Kaikaikaifang/Electronic-System-Design-Practice/原理图仿真/ppxA6AqUHD.jpg

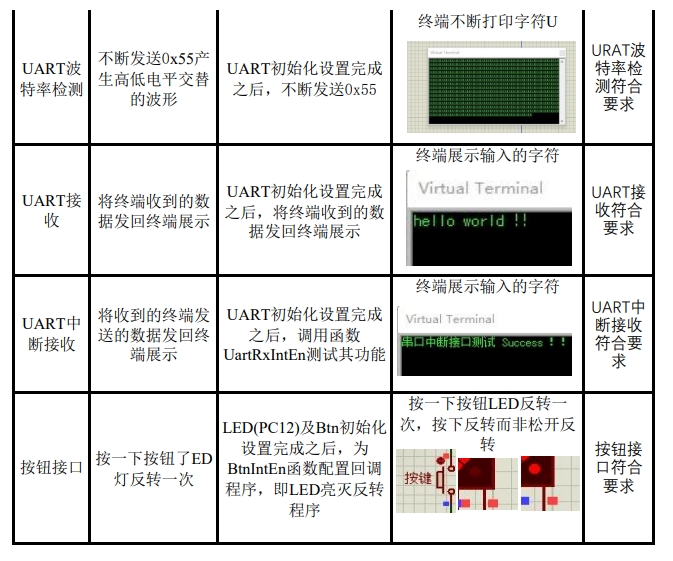
原理图仿真/ppxA6AqUHD.jpg
