Kaikaikaifang/Electronic-System-Design-Practice/线下实验/1.jpg

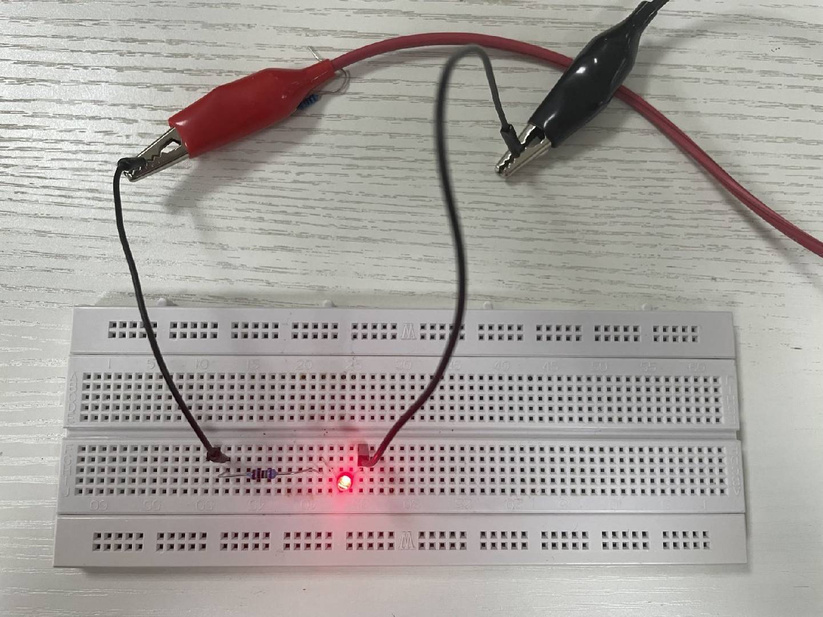
线下实验/1.jpg
