Kaikaikaifang/Electronic-System-Design-Practice/原理图仿真/原理图仿真 季开放 21009101425.pdf

模块 | 功能描述 | 程序设计思路 | 现象及描述 | 结果
LED驱动 模块 | 指示灯延时一段 时间亮灭切换一 次 | PC12初始化设置完成 后，周期改变PC12输 出，使指示灯亮灭交替 进行 | 数码管指示灯亮灭交替 | LED驱动 电路符 合要求
数码显示 | 定时循环显示0-9 | 初始化数码管驱动电路 后，周期改变数码管显 示数值 | 数码管显示数值0-9周期变 化 | 数码显 示符合 要求
定时器4 | 利用定时器4控制 LED的亮灭切换 | Tim4及PC12初始化设置 完成之后，用Tim4设置 0.5s定时来控制工作指 示灯亮灭切换 | 工作指示灯每隔0.5s切换 一次 | 定时器4 符合要 求
UART发 送 | 延时循环发送0-9 至终端 | UART初始化设置完成 之后，延时循环发送0-9 至终端 | 控制台循环打印字符0-9 | URAT发 送符合 要求
PWM控制 | 延时改变速度 | Motor初始化设置完成之 后，周期改变速度 | 示波器波形变化 | PWM控 制符合 要求
ADC测量 | 采集数据并通过 接口发送到终端 | 初始化设置Uart及 TempMeas后，周期测量 数据并通过串口发送到 终端 | 调节电阻发现，随电阻阻 值升高，采集到的数据变 大 | ADC测量 符合要 求
TIM2 | 利用定时器2控制 LED切换

Tim2及PC12初始化设置
完成后，用Tim2设置
0.2s定时来控制工作指
示灯亮灭切换

工作指示灯每隔0.2s切换
一次亮灭
TIM2符
合要求

原理图仿真记录表

UART波
特率检测

不断发送0x55产
生高低电平交替
的波形

UART初始化设置完成
之后，不断发送0x55

终端不断打印字符U
URAT波
特率检
测符合
要求

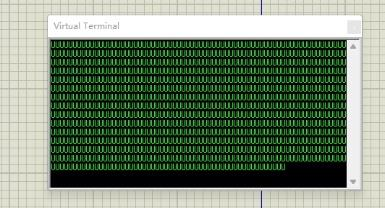
[picture p13: figure]

UART接 收 | 将终端收到的数 据发回终端展示 | UART初始化设置完成 之后，将终端收到的数 据发回终端展示 | 终端展示输入的字符 | UART接 收符合 要求
UART中 断接收 | 将收到的终端发 送的数据发回终 端展示 | UART初始化设置完成 之后，调用函数 UartRxIntEn测试其功能 | 终端展示输入的字符 | UART中 断接收 符合要 求
按钮接口 | 按一下按钮了ED 灯反转一次 | LED(PC12)及Btn初始化 设置完成之后，为 BtnIntEn函数配置回调 程序，即LED亮灭反转 程序 | 按一下按钮LED反转一 次，按下反转而非松开反 转 | 按钮接 口符合 要求
