Kaikaikaifang/Electronic-System-Design-Practice/PCB/PCB 检查汇总 季开放 21009101425.pdf

## PCB检查汇总

设计者姓名和学号 | 季开放 21009101425
错误类型 | 详细描述
元件错误或丢失 | 无

注：每类错误，若行数不够，可自行加行。

元件位号错误或
丢失

无

连接错误或丢失

无

导线太窄

无

导线太近

无

所有地是否连接
在一起

否

姓名和学号是否 标注 | 是
其它错误 | 无
