Kaikaikaifang/Electronic-System-Design-Practice/PCB/7NOwkH1fQ8.jpg

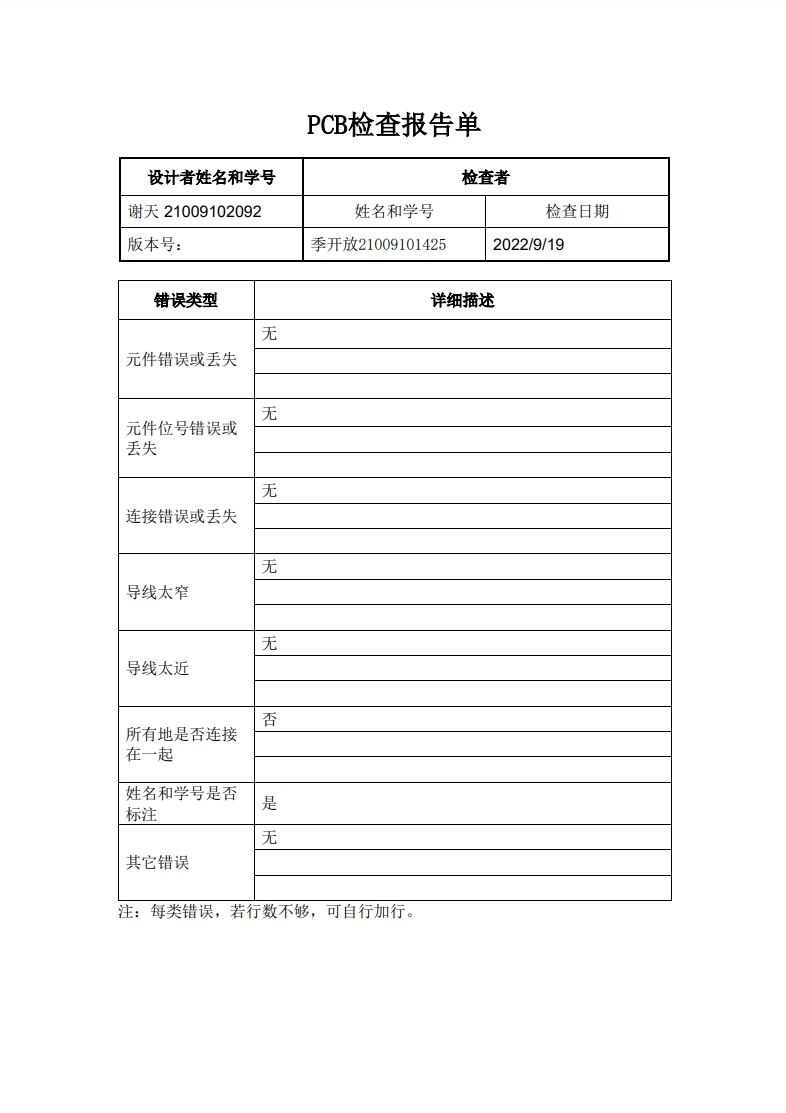
PCB/7NOwkH1fQ8.jpg
