Kaikaikaifang/Electronic-System-Design-Practice/PCB/ivbXwXM4Zm.jpg

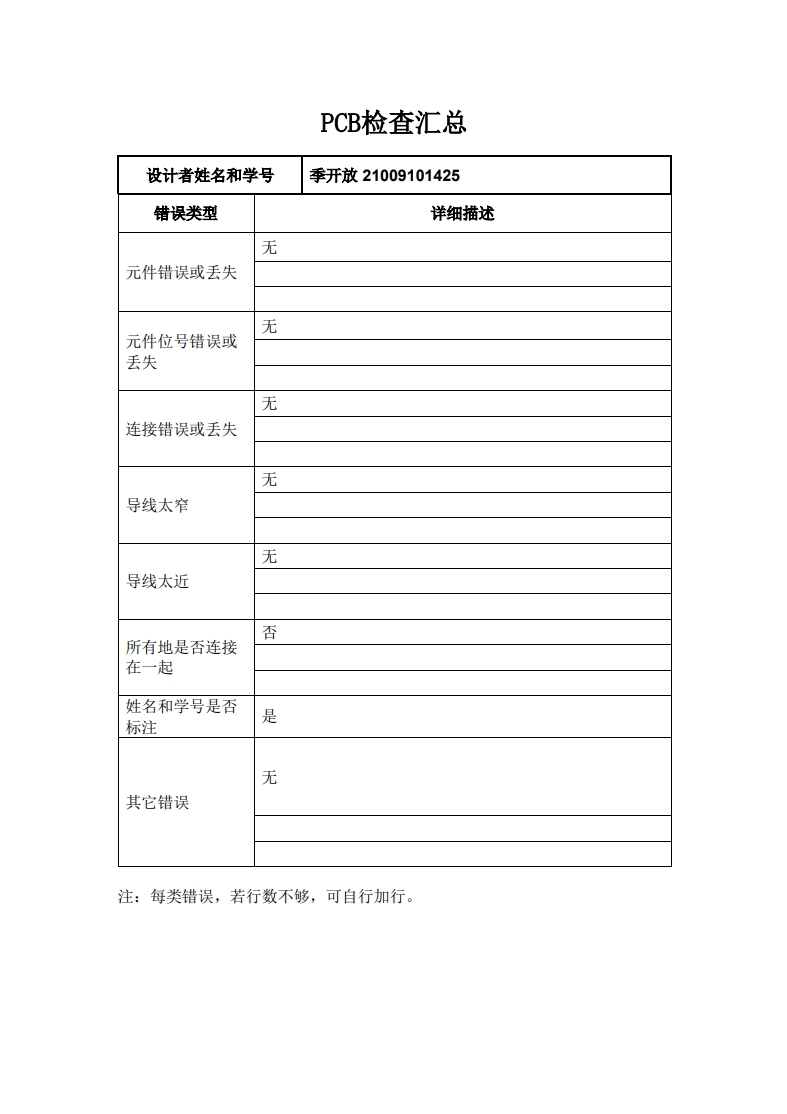
PCB/ivbXwXM4Zm.jpg
