Kaikaikaifang/Electronic-System-Design-Practice/PCB/SDzEGWgmNF.jpg

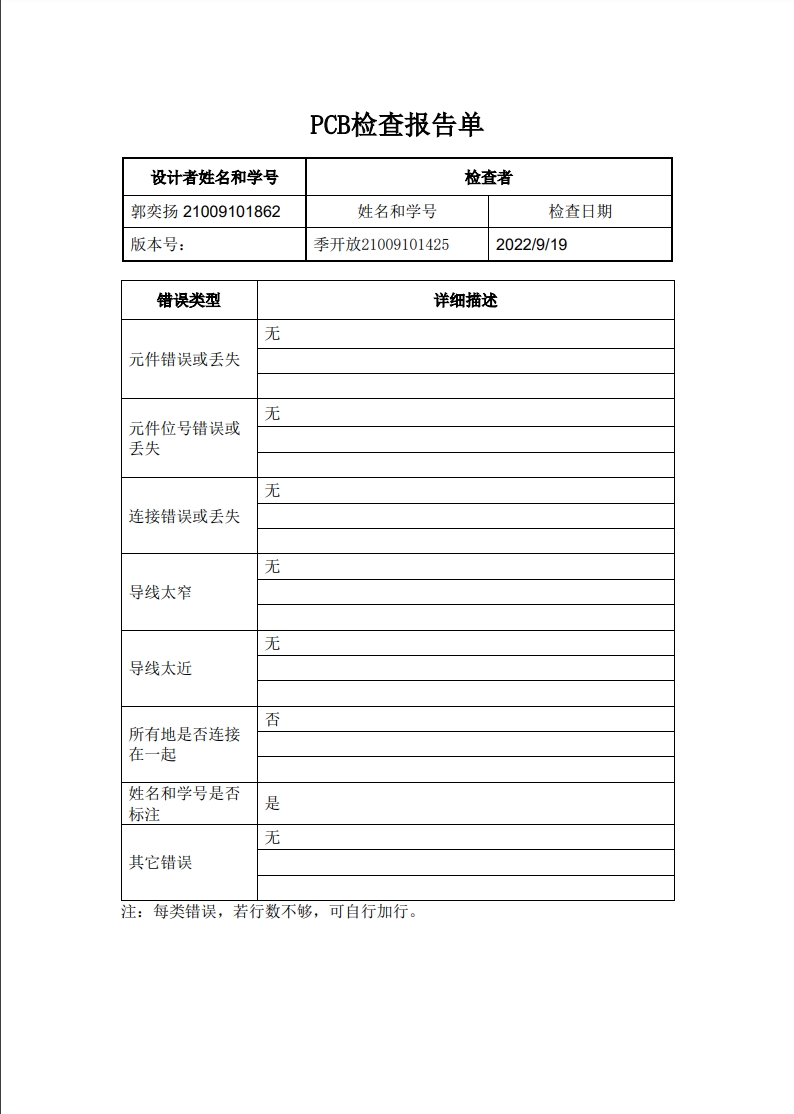
PCB/SDzEGWgmNF.jpg
