Kaikaikaifang/Electronic-System-Design-Practice/原理图仿真/5Mq5GWQv8Y.jpg

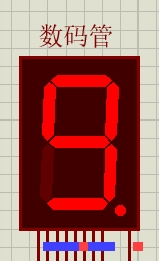
原理图仿真/5Mq5GWQv8Y.jpg
