Kaikaikaifang/Electronic-System-Design-Practice/原理图仿真/co1uGrUOXY.jpg

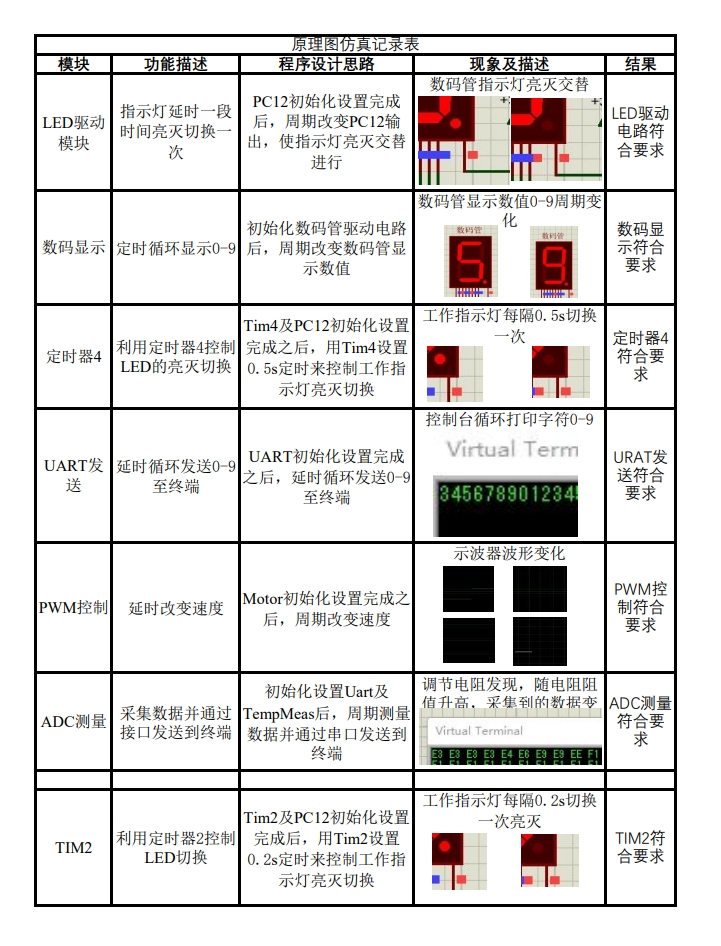
原理图仿真/co1uGrUOXY.jpg
