Kaikaikaifang/Electronic-System-Design-Practice/原理图仿真/EEQ70Q8Gmv.jpg

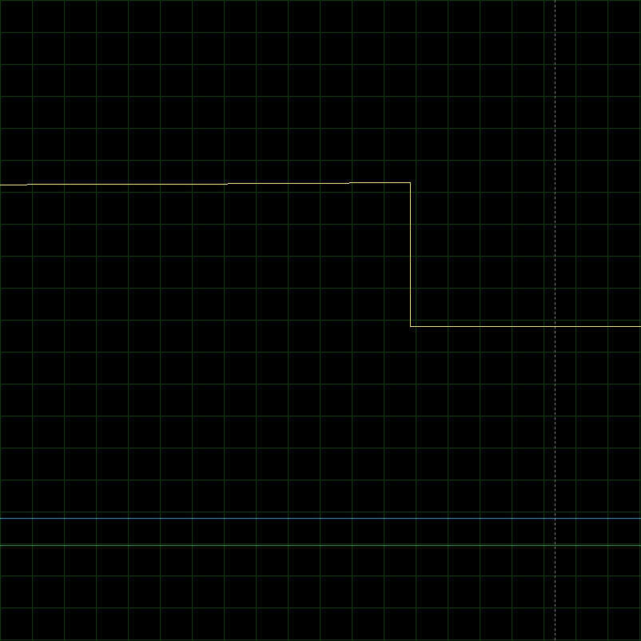
原理图仿真/EEQ70Q8Gmv.jpg
