Kaikaikaifang/Electronic-System-Design-Practice/原理图仿真/hpIczdKIwC.jpg

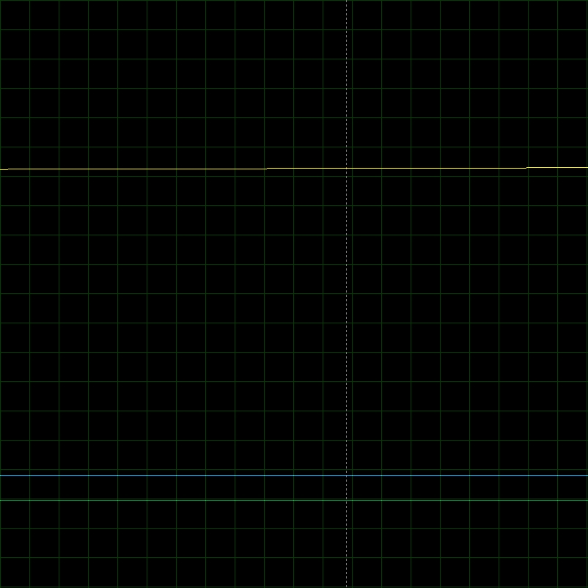
原理图仿真/hpIczdKIwC.jpg
