Kaikaikaifang/Electronic-System-Design-Practice/原理图仿真/kEwEND1PZP.jpg

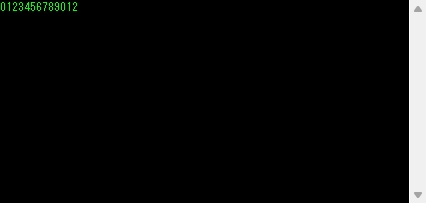
原理图仿真/kEwEND1PZP.jpg
