Kaikaikaifang/Electronic-System-Design-Practice/原理图仿真/qdkJ55apnM.jpg

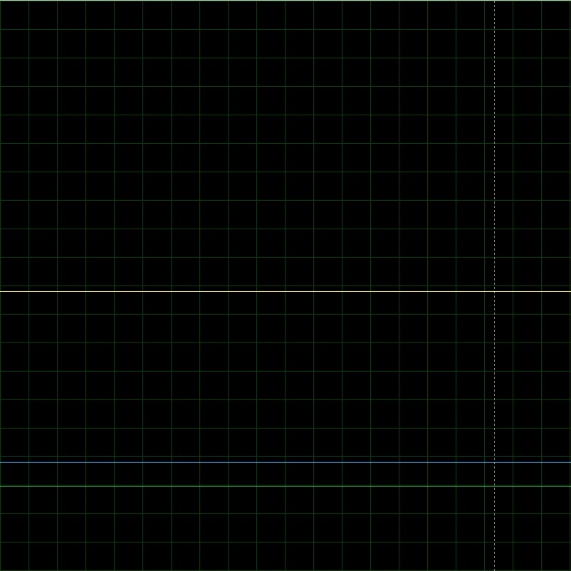
原理图仿真/qdkJ55apnM.jpg
