Kaikaikaifang/Electronic-System-Design-Practice/原理图仿真/Uw2hf80zc7.jpg

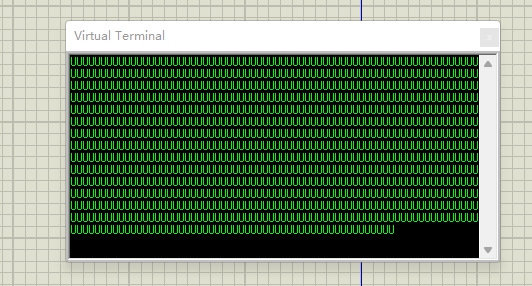
原理图仿真/Uw2hf80zc7.jpg
