Kaikaikaifang/Electronic-System-Design-Practice/原理图仿真/XrYr4p36AL.jpg

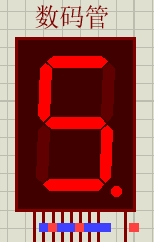
原理图仿真/XrYr4p36AL.jpg
