Kaikaikaifang/Electronic-System-Design-Practice/原理图仿真/zDXhK026yv.jpg

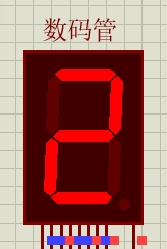
原理图仿真/zDXhK026yv.jpg
