Kaikaikaifang/Electronic-System-Design-Practice/线下实验/3.jpg

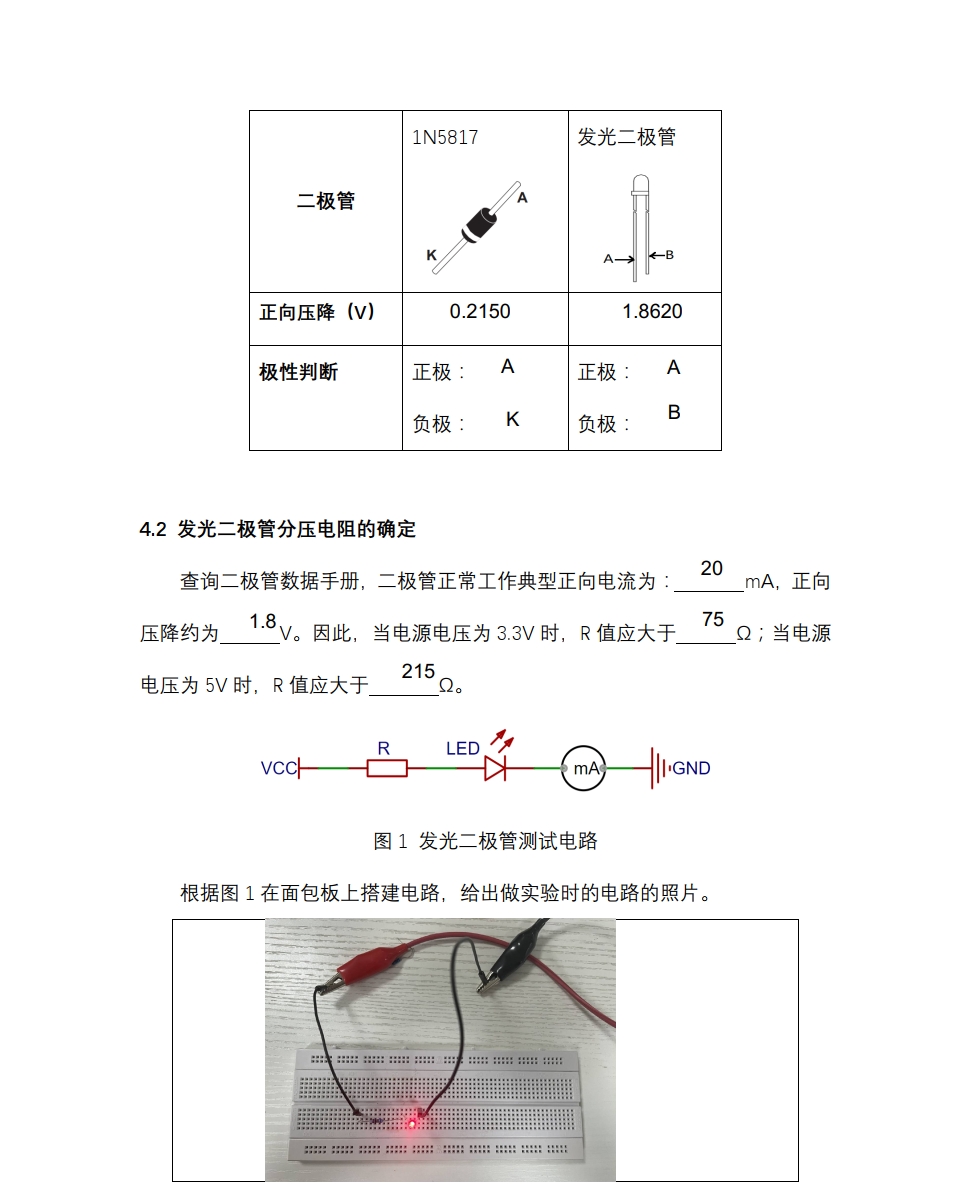
线下实验/3.jpg
