Kaikaikaifang/Electronic-System-Design-Practice/线下实验/4.jpg

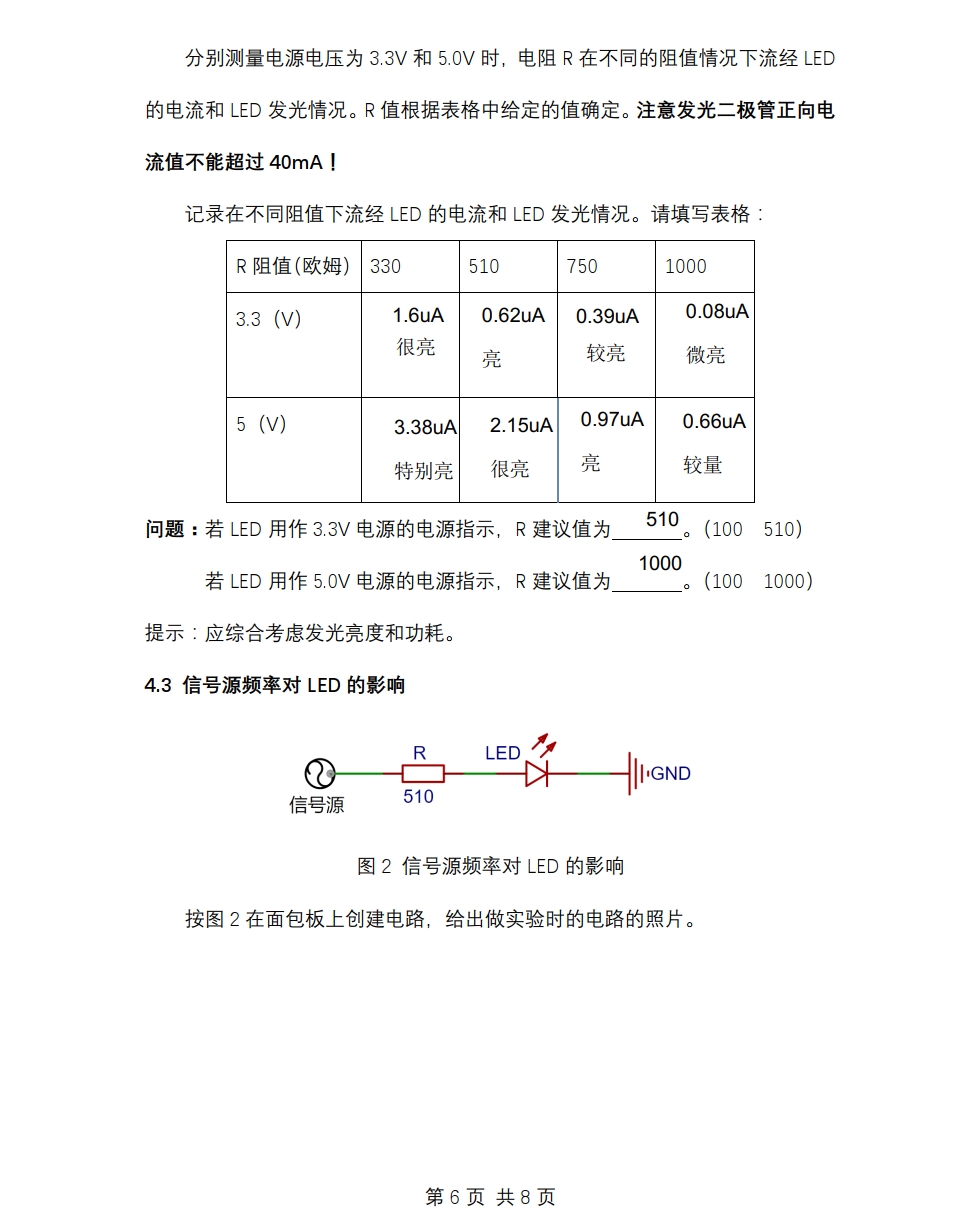
线下实验/4.jpg
