Kaikaikaifang/Electronic-System-Design-Practice/线下实验/5.jpg

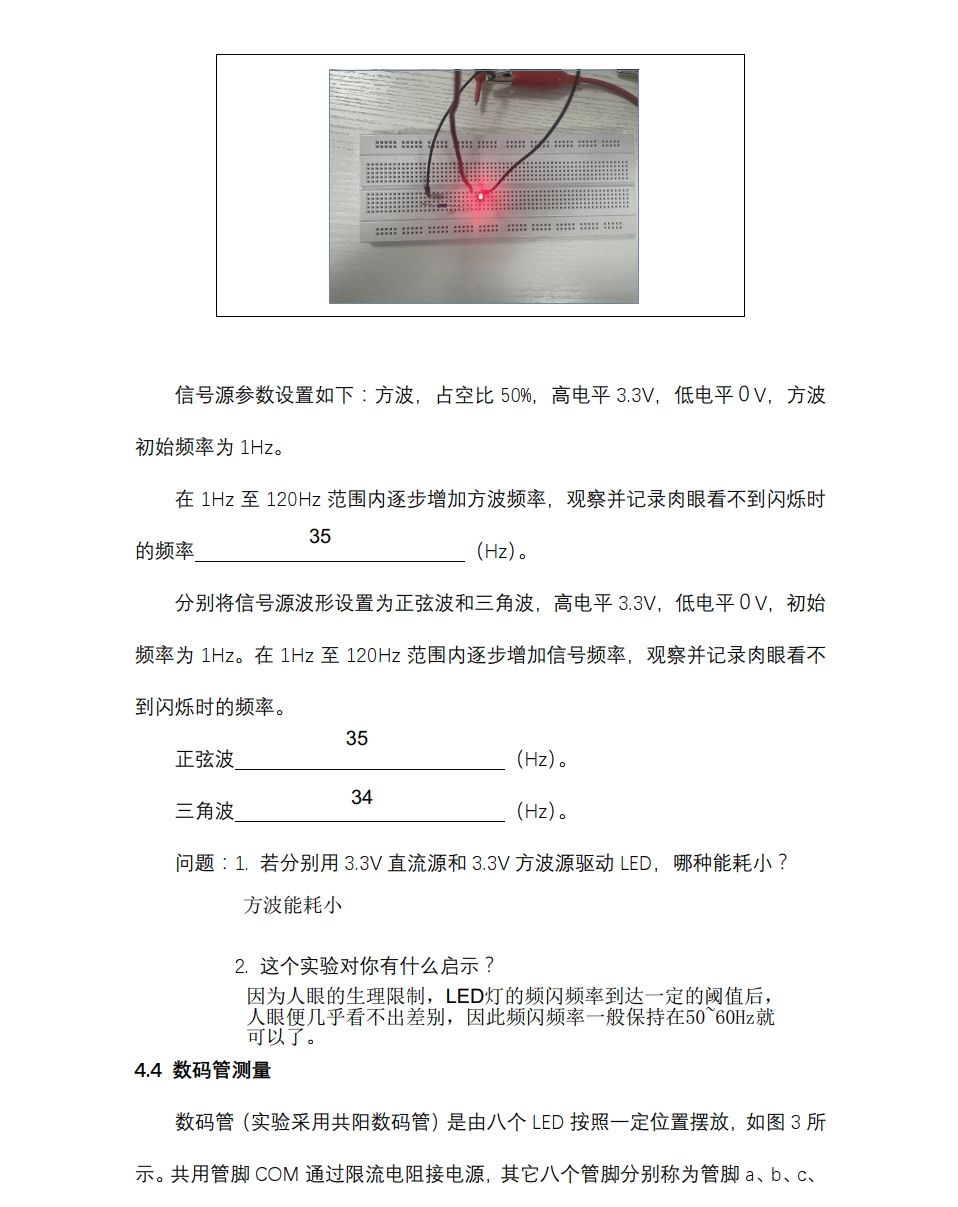
线下实验/5.jpg
