Kaikaikaifang/Electronic-System-Design-Practice/线下实验/6.jpg

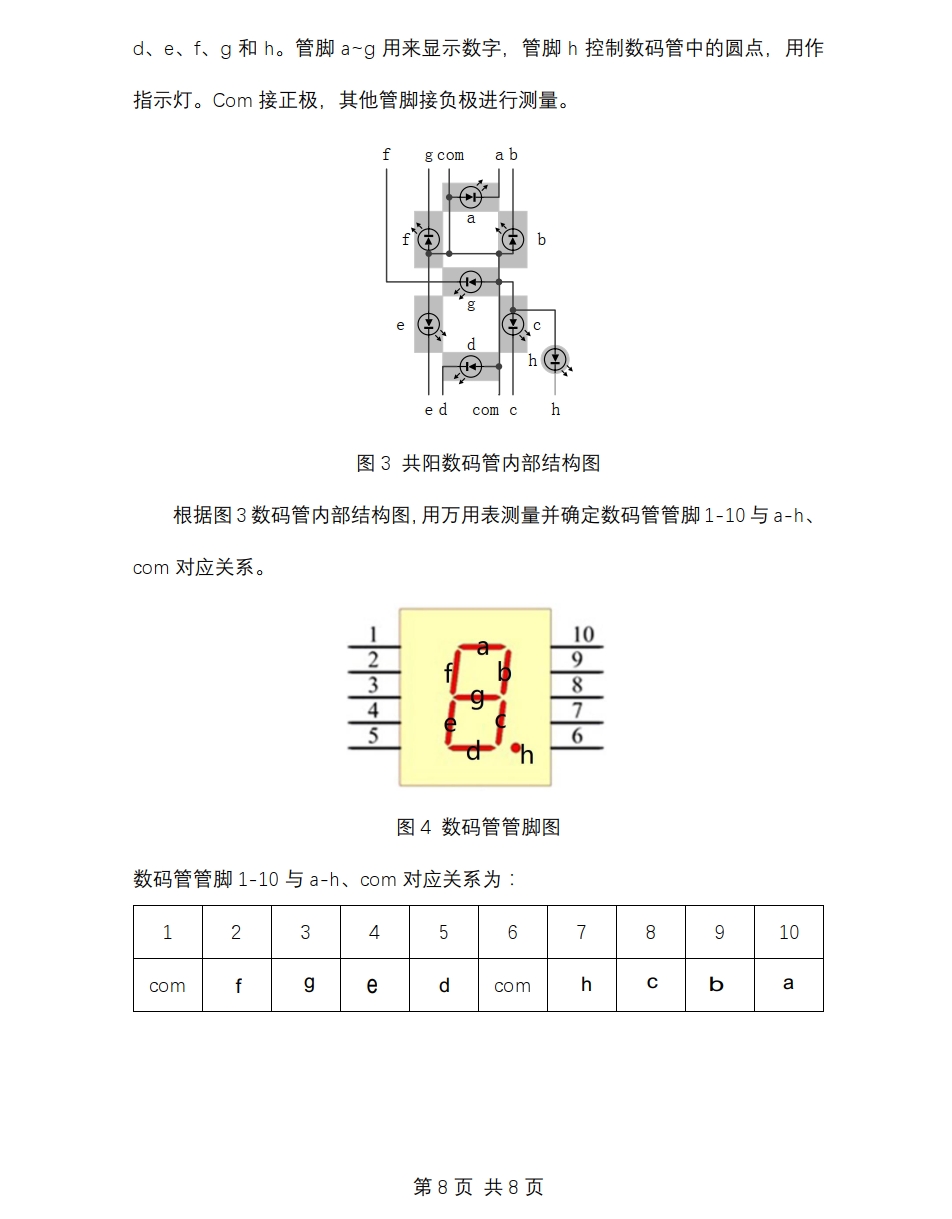
线下实验/6.jpg
