Kaikaikaifang/Electronic-System-Design-Practice/线下实验/10.jpg

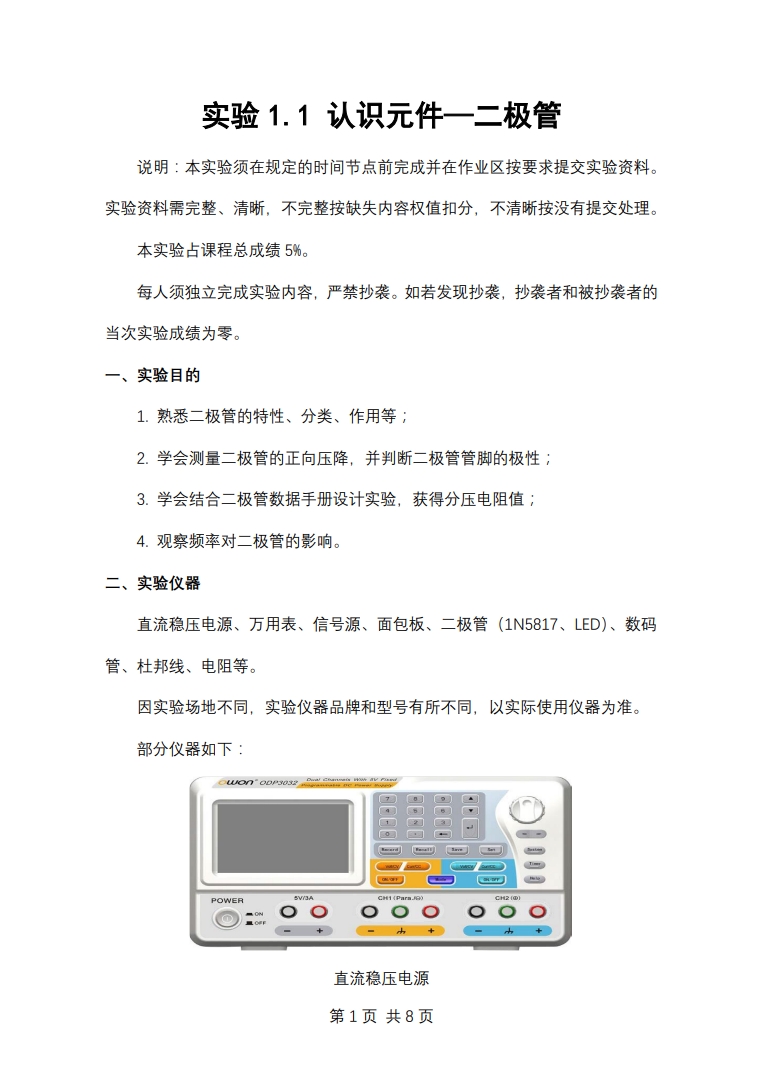
线下实验/10.jpg
