Kaikaikaifang/Electronic-System-Design-Practice/线下实验/11.jpg

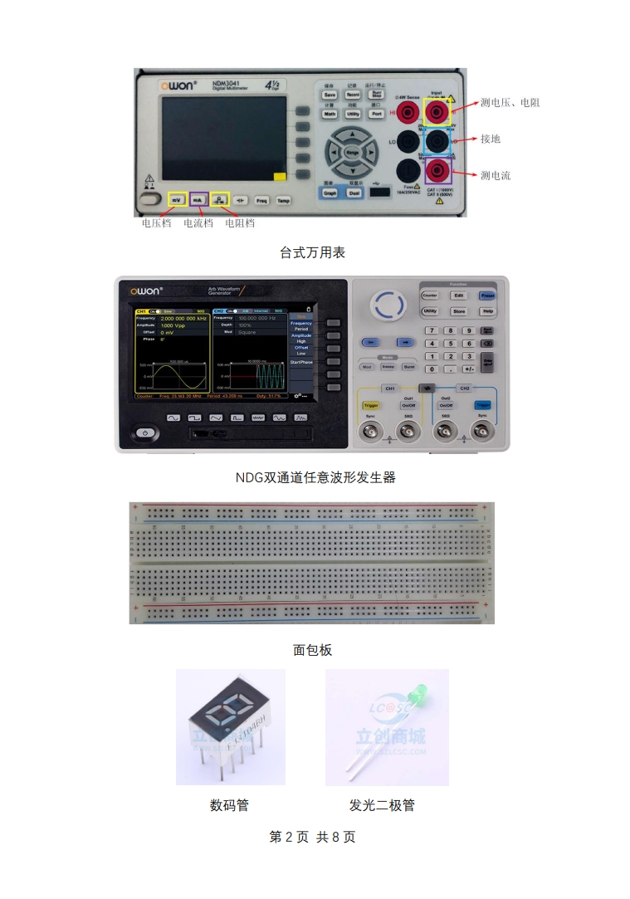
线下实验/11.jpg
