Kaikaikaifang/Electronic-System-Design-Practice/线下实验/12.jpg

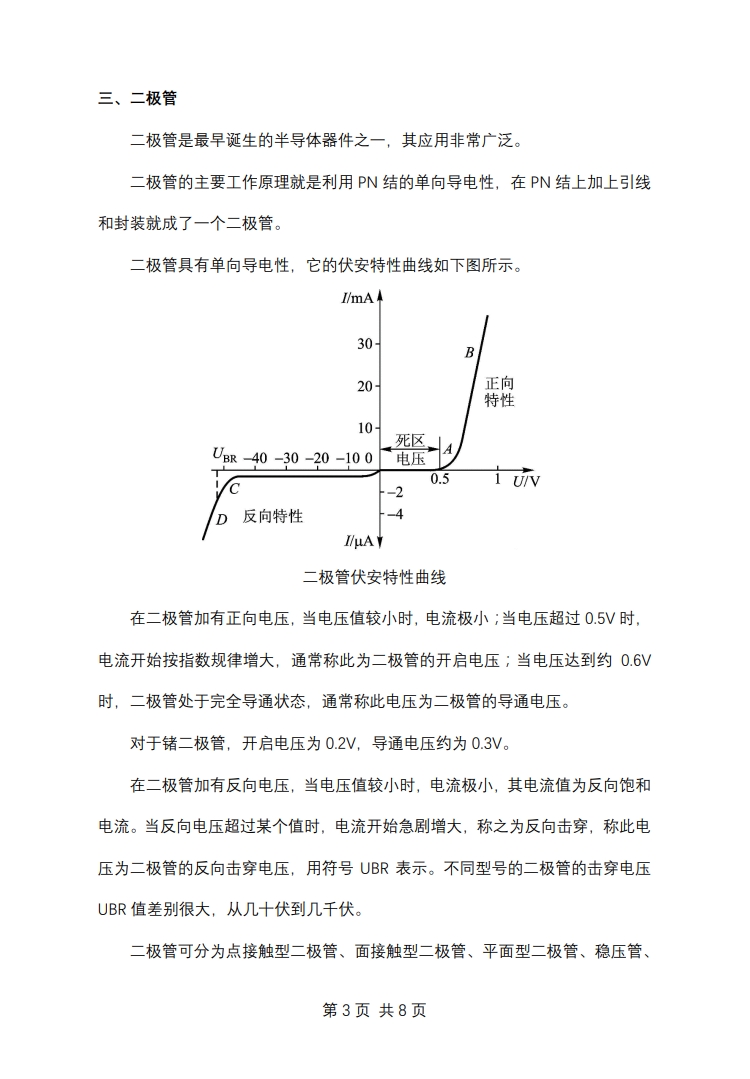
线下实验/12.jpg
