Kaikaikaifang/Electronic-System-Design-Practice/线下实验/13.jpg

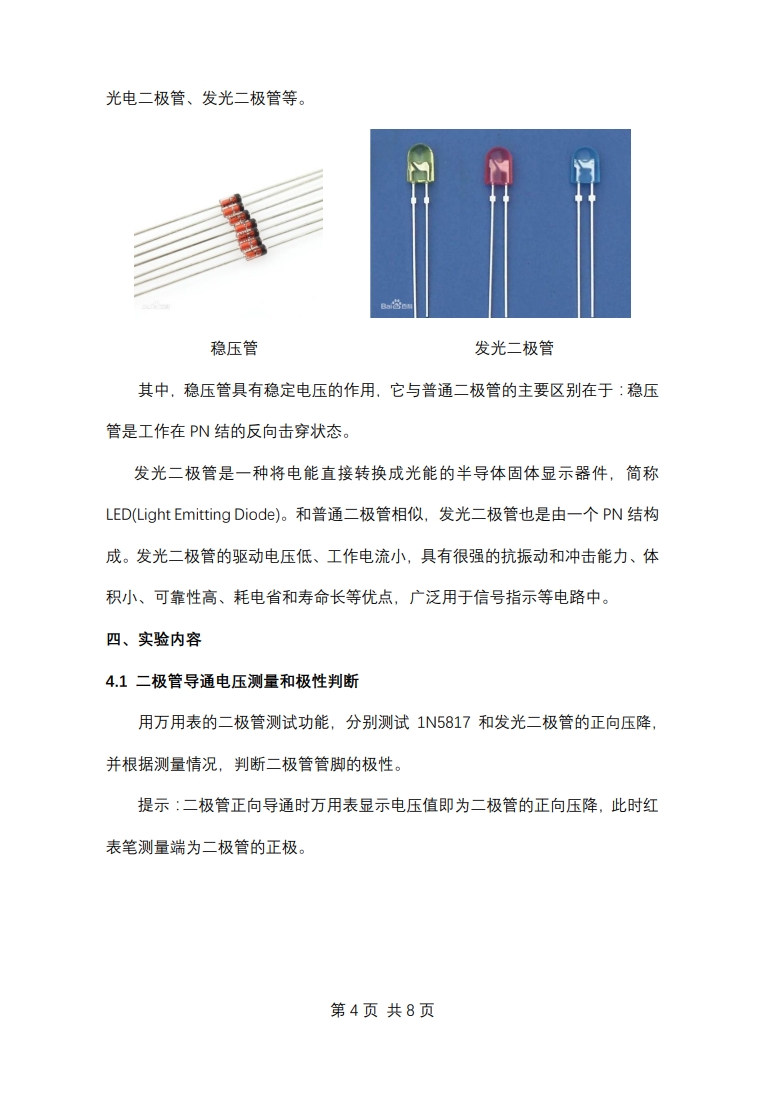
线下实验/13.jpg
