Kaikaikaifang/Electronic-System-Design-Practice/docs/BOM_PCB.xlsx

ID | Name | Designator | Footprint | Quantity | Manufacturer Part | Manufacturer | Supplier | Supplier Part | Price
1 | 54101-T06-00 | GND2,GND1,3V3,T1,T2,T3,T4,T5,T6 | HDR-TH_1P-P2.54-V-M | 9 | 54101-T06-00 | Amphenol ICC | LCSC | C213463 | 0.1272
2 | 100nF | C2,C5,C16,C17,C18,C19,C20,C21 | CAP-TH_L5.5-W2.5-P5.00-D1.0 | 8 | CT4-0805B104K500F3 | FH | LCSC | C84772 | 0.1845
3 | TS665CJ | B2 | SW-TH_4P-L6.0-W6.0-P4.50-LS6.5 | 1 | TS665CJ | SHOU HAN | LCSC | C393938 | 0.0873
4 | 10uF | C1 | CAP-TH_BD5.0-P2.00-D0.6-FD | 1 | 50V10uF CD110 | HRK(鸿瑞凯电子) | LCSC | C2960200 | 0.0763
5 | 1N5817_C169165 | D1 | DO-41_BD2.4-L4.7-P8.70-D0.9-RD | 1 | 1N5817 | DIOFIT | LCSC | C169165 | 0.1355
6 | TJ-L3FYTGHTFCLFLC2R-A5 | D2 | LED-TH_BD3.9-P2.54-FD | 1 | TJ-L3FYTGHTFCLFLC2R-A5 | TOGIALED | LCSC | C330746 | 0.1658
7 | A72-065 | F1 | FUSE-TH_L9.7-W3.1-P5.10-D0.6-S1.50 | 1 | A72-065 | JDTFUSE | LCSC | C135426 | 0.3994
8 | FOR_CN10 | J1 | HDR-TH_38P-P2.54-V-F-R2-C19-S2.54 | 1 | PM254-2-19-Z-8.5 | HCTL(华灿天禄) | LCSC | C2897420 | 3.11
9 | FOR_CN7 | J2 | HDR-TH_38P-P2.54-V-F-R2-C19-S2.54 | 1 | PM254-2-19-Z-8.5 | HCTL(华灿天禄) | LCSC | C2897420 | 3.11
10 | WJ124-3.81-3P | J6 | CONN-TH_3P-P3.81_WJ124-3.81-3P | 1 | WJ124-3.81-3P | ReliaPro | LCSC | C36780 | 1.4596
11 | WJ124-3.81-2P | J7,J8 | CONN-TH_2P-P3.81_KF124-3.81-2P | 2 | WJ124-3.81-2P | ReliaPro | LCSC | C69811 | 0.9628
12 | SS-12D10L5 | K1 | SW-TH_SS-12D10L5 | 1 | SS-12D10L5 | XKB Enterprise | LCSC | C319012 | 1.4196
13 | FJ3104BH | LEDS | LED-SEG-TH_10P-L12.7-W7.6-P2.54-LS5.08-TL | 1 | FJ3104BH | 志浩 | LCSC | C2938319 | 1.8491
14 | S9013 | Q1 | TO-92-3_L4.9-W3.7-P1.27-L | 1 | S9013 | CJ | LCSC | C6748 | 0.2225
15 | 510 | R1,R7 | RES-TH_BD1.8-L3.2-P7.20-D0.4 | 2 | MF1/8W-10KΩ±1%T52 | Huaxing Mechanical-Elec. | LCSC | C713919 | 0.0335
16 | 4.7K | R4 | RES-TH_BD1.8-L3.2-P7.20-D0.4 | 1 | MF1/8W-10KΩ±1%T52 | Huaxing Mechanical-Elec. | LCSC | C713919 | 0.0335
17 | 100 | R5 | RES-TH_BD1.8-L3.2-P7.20-D0.4 | 1 | MF1/8W-10KΩ±1%T52 | Huaxing Mechanical-Elec. | LCSC | C713919 | 0.0335
18 | 10kΩ | R6 | RES-TH_BD1.8-L3.2-P7.20-D0.4 | 1 | MF1/8W-10KΩ±1%T52 | Huaxing Mechanical-Elec. | LCSC | C713919 | 0.0335
19 | 510 | R9,R10,R11,R12,R13,R14,R15,R16 | RES-TH_BD1.8-L3.2-P7.20-D0.4 | 8 | - | Chian Chia Elec | LCSC | C119149 | 0.0495
20 | JPD1030-N521-4F | S1 | DC-IN-TH_JPD1030-N521-4F | 1 | JPD1030-N521-4F | FOXCONN(富士康) | LCSC | C426213 | 1.8418
21 | HT7533-1_C32617 | U1 | TO-92-3_L4.9-W3.7-P1.27-L | 1 | HT7533-1 | HOLTEK | LCSC | C32617 | 1.8552
22 | MAX3232CSE+ | U2 | SO-16_L10.0-W4.0-P1.27-LS6.2-BL | 1 | MAX3232CSE+ | Maxim Integrated | LCSC | C143430 | 37.67
