Kaikaikaifang/Electronic-System-Design-Practice/PCB/PCB季开放21009101425.pdf

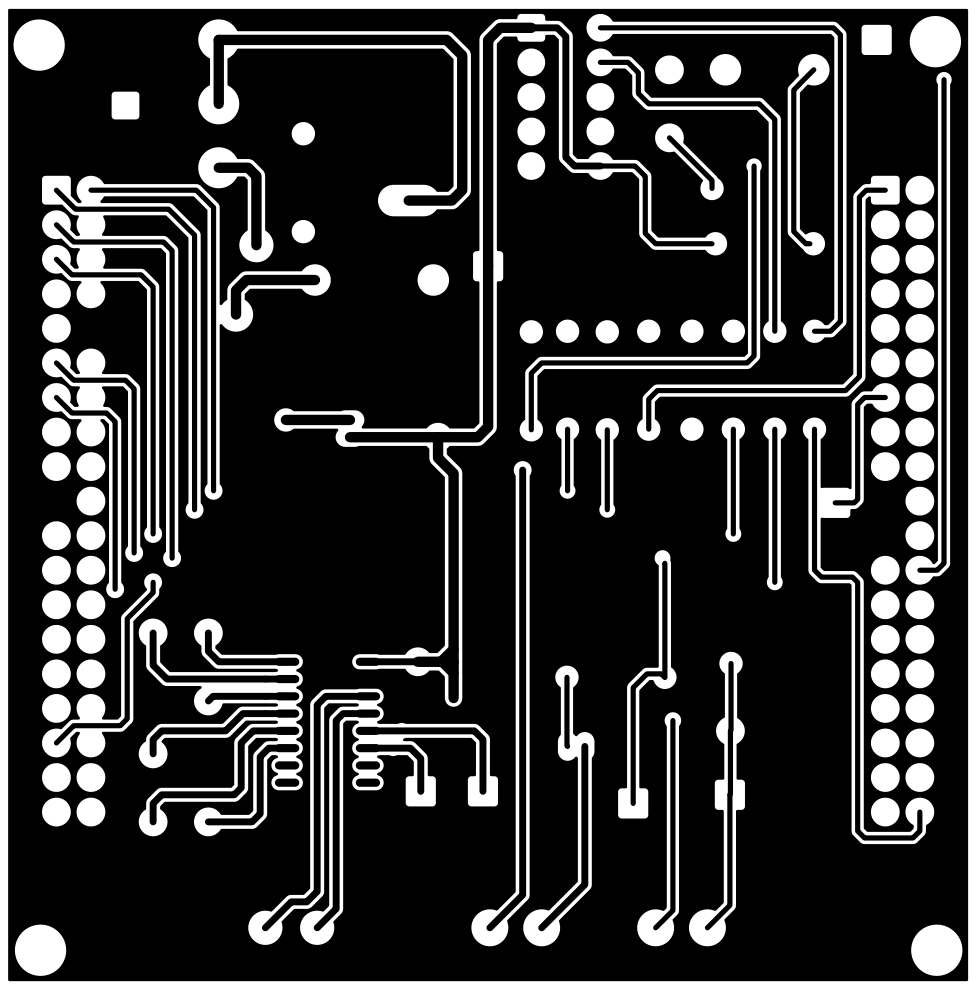
[picture p51: page 1]

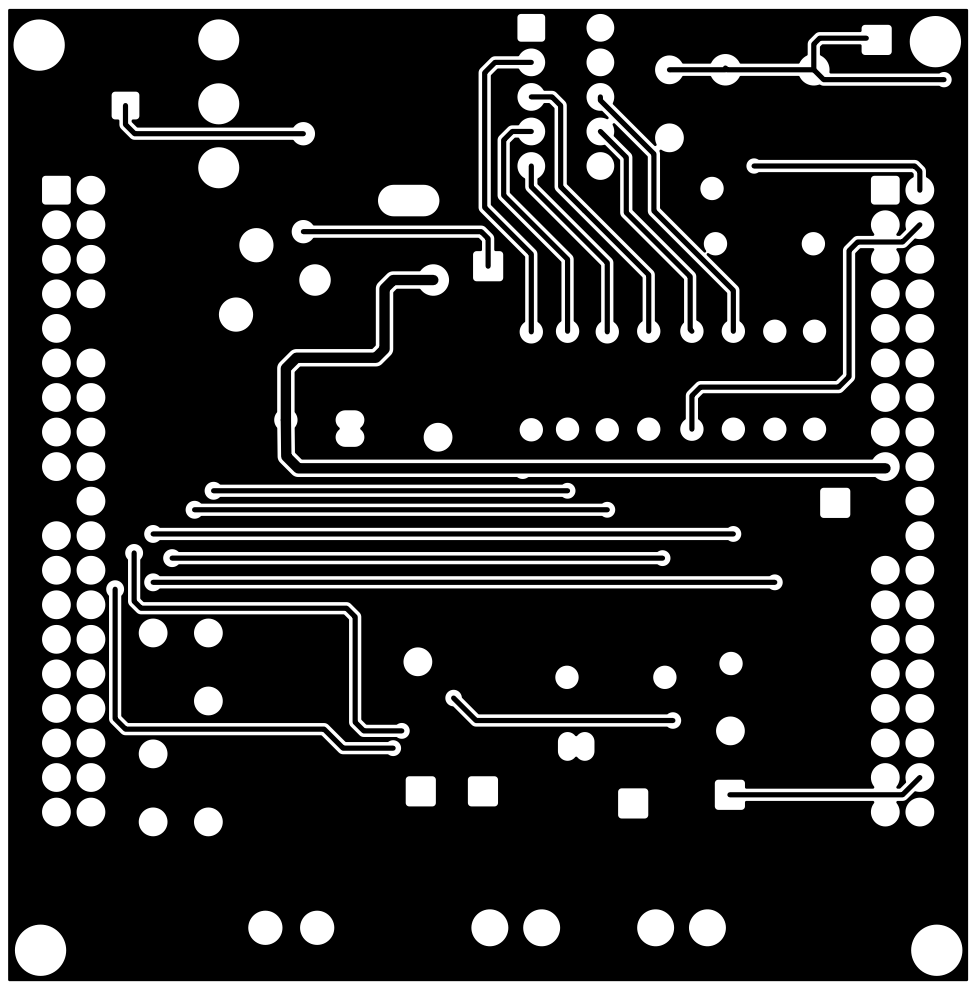
[picture p52: page 2]

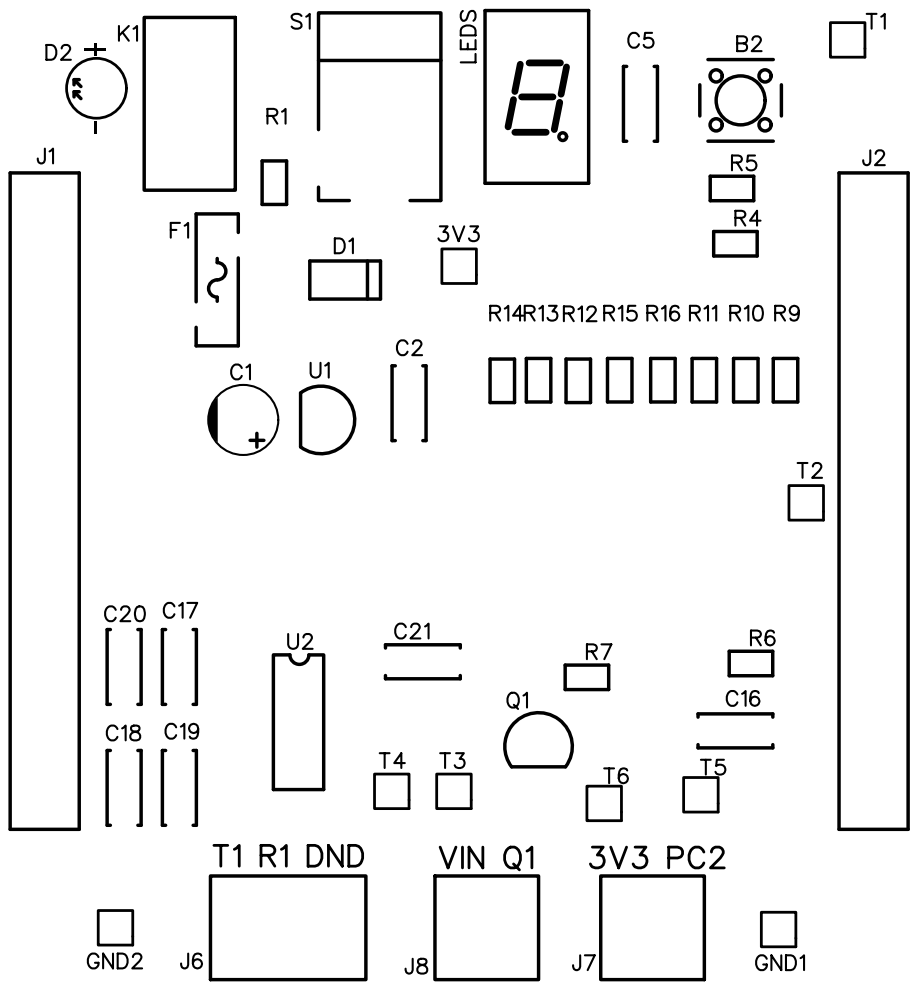
[picture p53: page 3]
