Kaikaikaifang/Electronic-System-Design-Practice/PCB/SCH季开放21009101425.pdf

## 显示电路

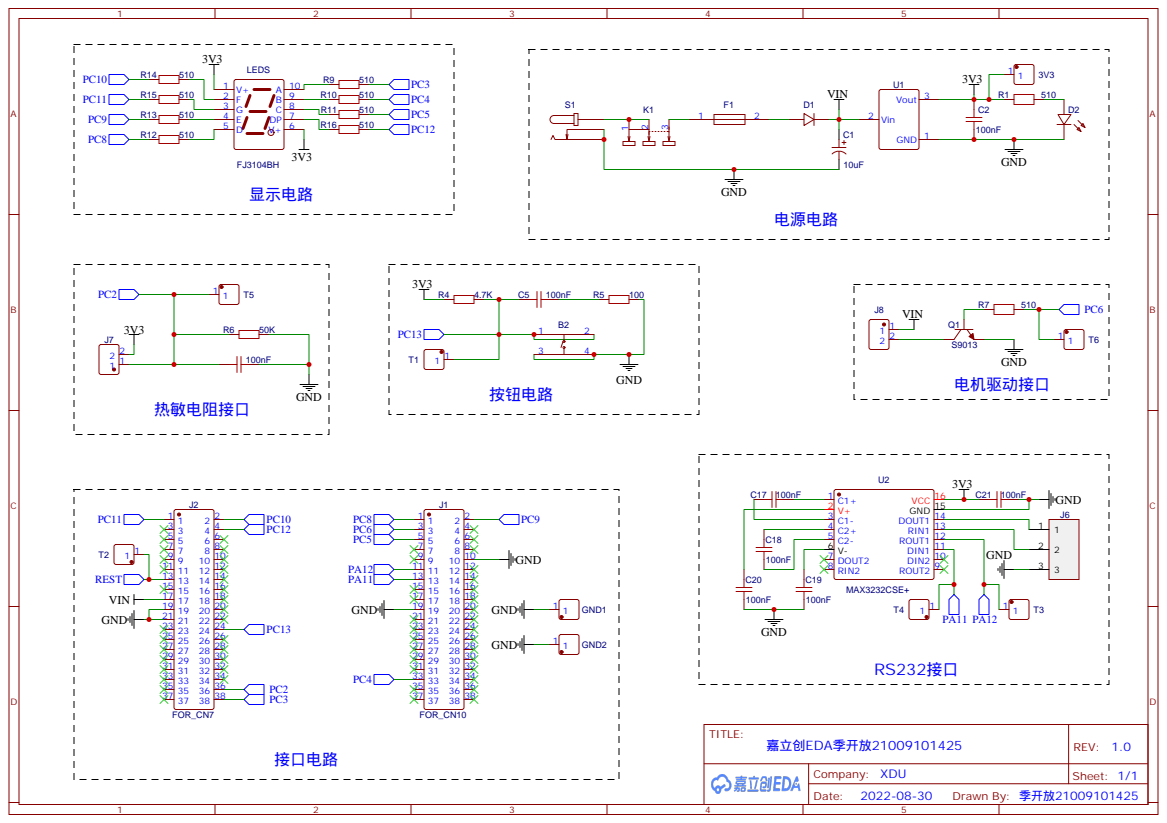
[picture p54: page 1]
