Kaikaikaifang/Electronic-System-Design-Practice/docs/PCB_参考.pdf

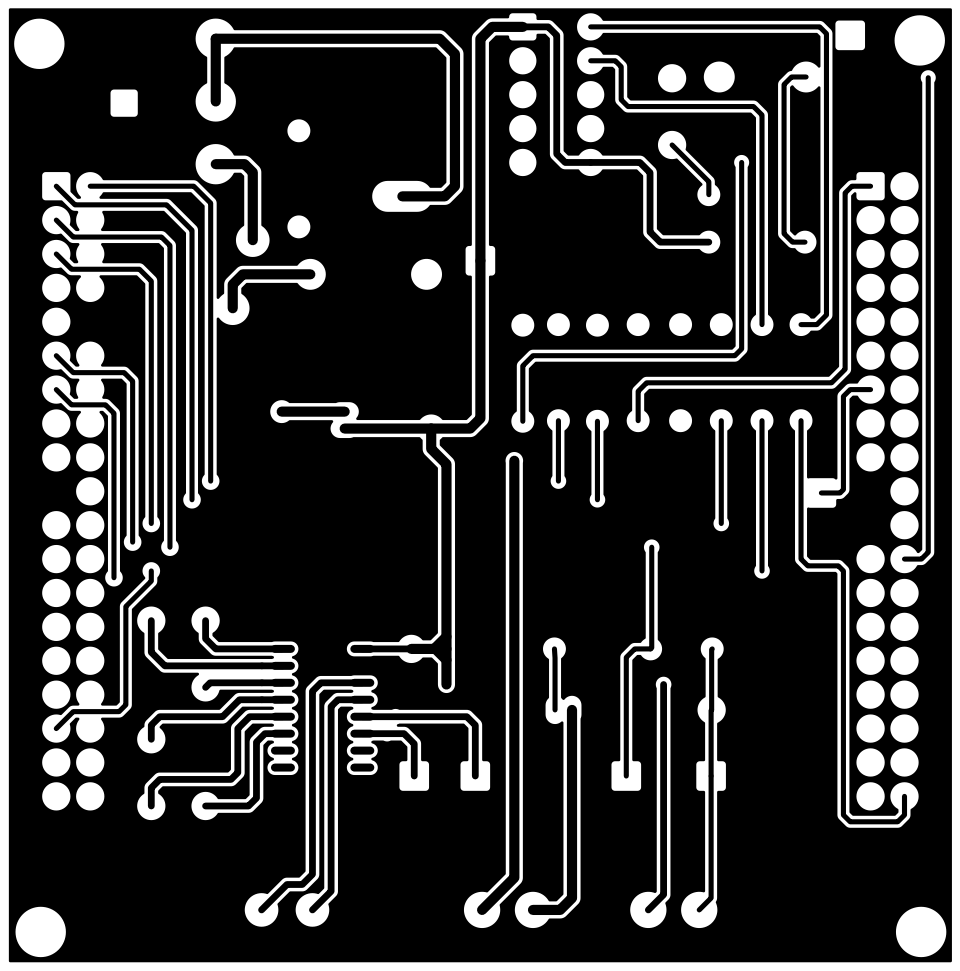
[picture p55: page 1]

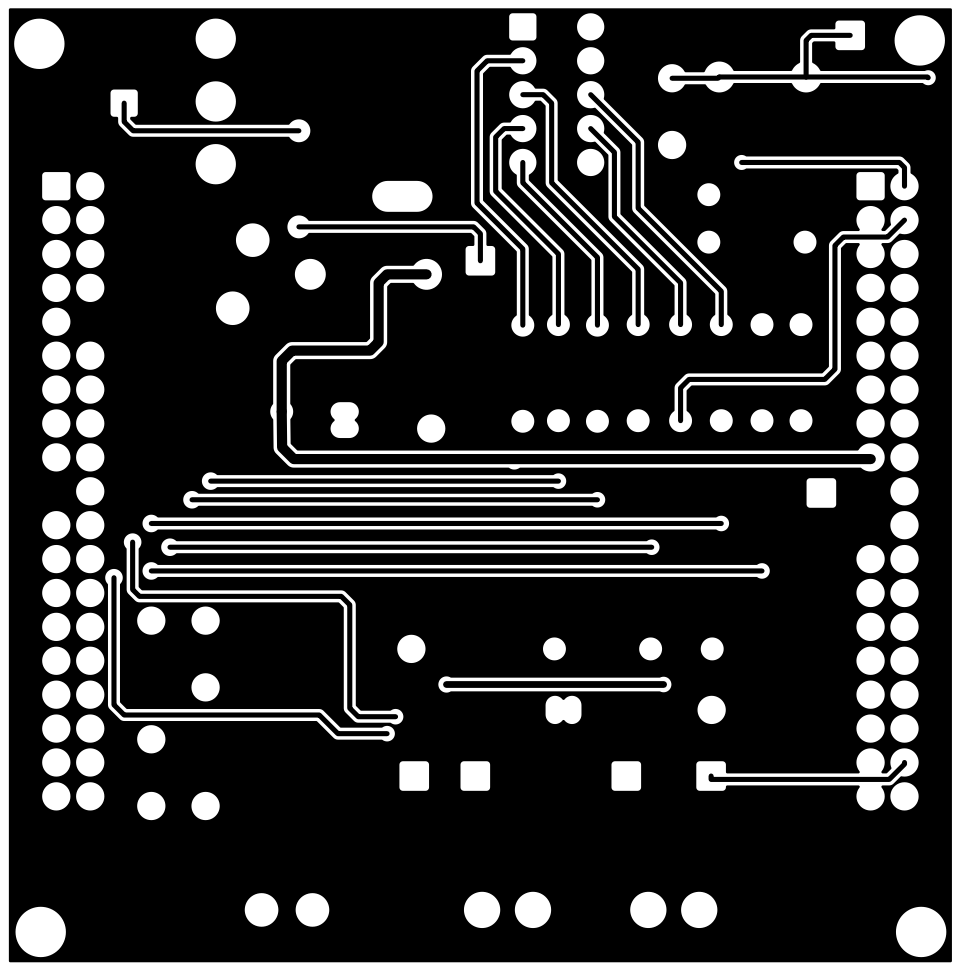
[picture p56: page 2]

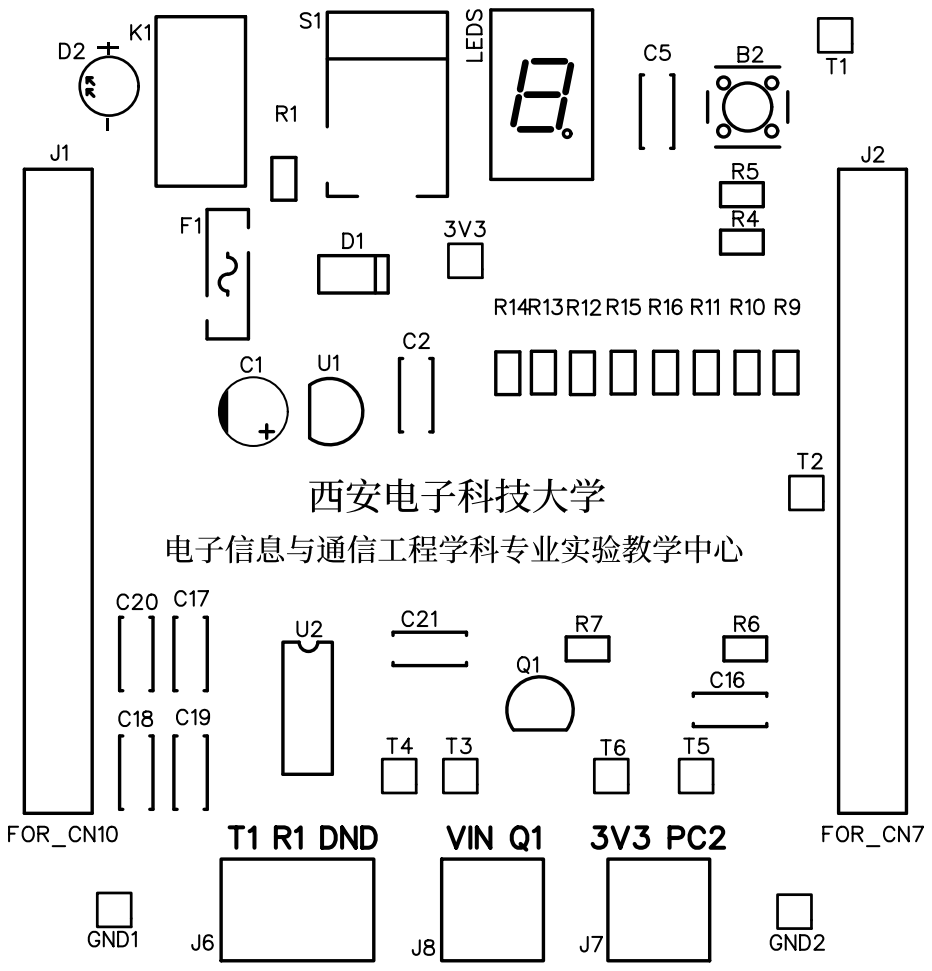
[picture p57: page 3]
