Kaikaikaifang/Electronic-System-Design-Practice/docs/SCH.pdf

## 显示电路

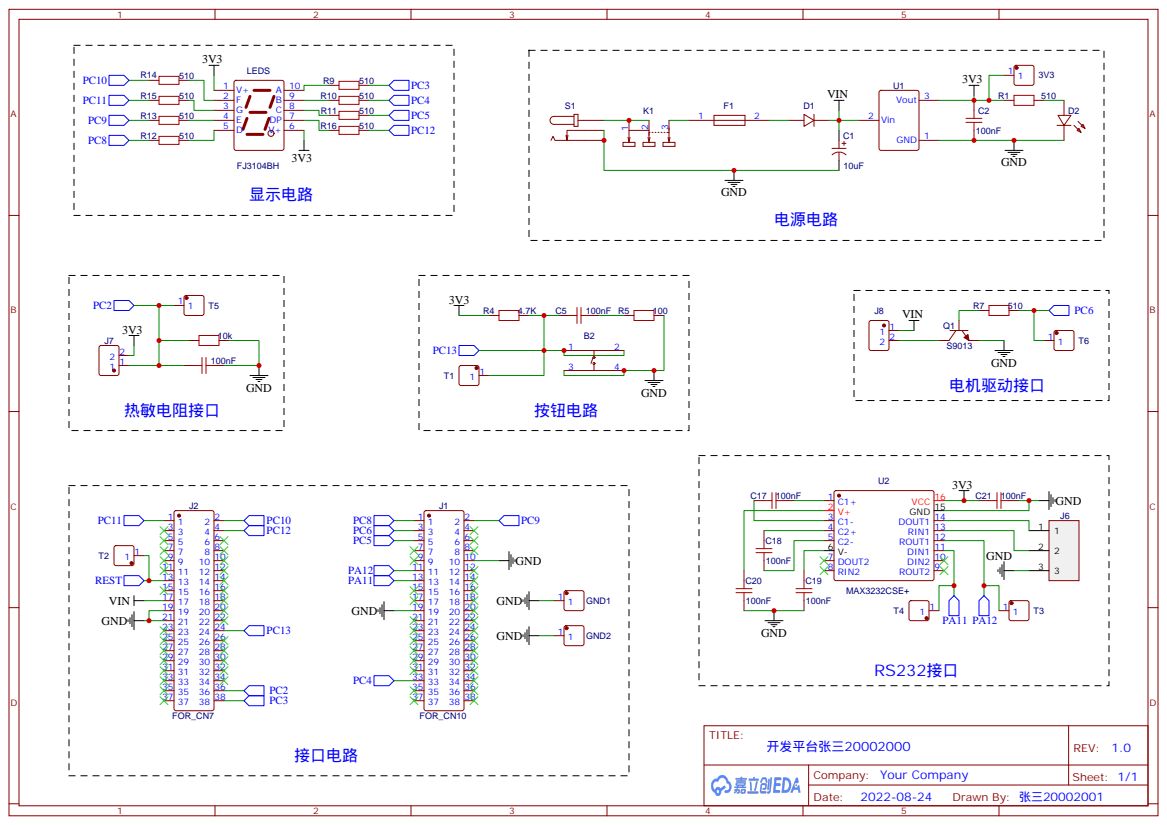
[picture p58: page 1]
