Kaikaikaifang/Electronic-System-Design-Practice/(list of files, drawings)

Other design files:
PCB/Project Backups/test_auto_ctrl_dbg [20220925, 12-57-17].pdsprj
PCB/Project Backups/test_auto_ctrl_dbg [20220925, 13-02-32].pdsprj
PCB/Project Backups/test_auto_ctrl_dbg [20220925, 13-03-02].pdsprj
PCB/Project Backups/test_auto_ctrl_dbg [20220925, 13-09-37].pdsprj
PCB/Project Backups/test_auto_ctrl_dbg [20220925, 13-09-40].pdsprj
PCB/Project Backups/test_auto_ctrl_dbg [20220925, 13-18-31].pdsprj
PCB/Project Backups/test_auto_ctrl_dbg [20220925, 13-18-59].pdsprj
PCB/Project Backups/test_auto_ctrl_dbg [20220925, 13-19-44].pdsprj
PCB/Project Backups/test_auto_ctrl_dbg [20220925, 13-20-06].pdsprj
PCB/Project Backups/test_auto_ctrl_dbg [20220925, 13-21-55].pdsprj
PCB/SCH_2022-09-02.json
PCB/test_auto_ctrl_dbg.pdsprj
原理图仿真/test_auto_ctrl_dbg.pdsprj
