Kaikaikaifang/Electronic-System-Design-Practice/(commit log)

2022-08-30 docs: offer by teacher
    [BOM_PCB.xlsx, BOM_典型微控制系统设计开发_2022-08-26.csv]
2022-09-09 homework: PCB
    [BOM_PCB.xlsx, BOM_典型微控制系统设计开发_2022-08-26.csv, SCH_2022-09-02.json, 原理图校验.xlsx]
2022-09-19 homework: 原理图仿真
    [test_auto_ctrl_dbg.pdsprj, 原理图仿真.xlsx]
2022-09-24 learn: 原理图仿真
    [test_auto_ctrl_dbg [20220923, 20-15-26].pdsprj, test_auto_ctrl_dbg [20220923, 20-15-39].pdsprj, test_auto_ctrl_dbg [20220923, 20-16-45].pdsprj, test_auto_ctrl_dbg [20220923, 20-17-28].pdsprj, test_auto_ctrl_dbg [20220923, 20-17-40].pdsprj, test_auto_ctrl_dbg [20220923, 20-38-19].pdsprj, test_auto_ctrl_dbg [20220923, 20-38-45].pdsprj, test_auto_ctrl_dbg [20220923, 20-38-46].pdsprj]
2022-09-26 learn :+1:原理图仿真
    [test_auto_ctrl_dbg [20220923, 20-15-26].pdsprj, test_auto_ctrl_dbg [20220923, 20-15-39].pdsprj, test_auto_ctrl_dbg [20220923, 20-16-45].pdsprj, test_auto_ctrl_dbg [20220923, 20-17-28].pdsprj, test_auto_ctrl_dbg [20220923, 20-17-40].pdsprj, test_auto_ctrl_dbg [20220923, 20-38-19].pdsprj, test_auto_ctrl_dbg [20220923, 20-38-45].pdsprj, test_auto_ctrl_dbg [20220923, 20-38-46].pdsprj]
2022-10-08 docs: 线下实验
